khanhdo3997-del/CE2103/README.md

# CE2103
fireAlarm
Link web base: https://fire-frontend-render.onrender.com/
Link MQTT: https://www.hivemq.com/demos/websocket-client/ - Topic: CE2103/firedetect
